jhk1m/charcoal-smoker/assets/COMPONENT_TO_INTEGRATE_REPLACE_V1.png

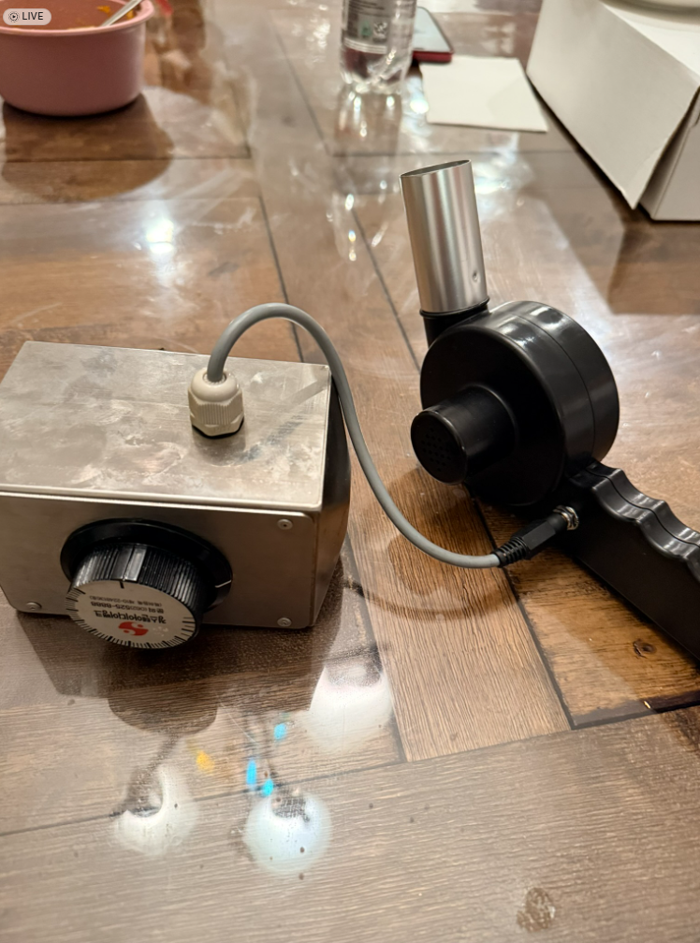
assets/COMPONENT_TO_INTEGRATE_REPLACE_V1.png
