jhk1m/charcoal-smoker/assets/FAN_CONTROLLER_ONOFF_DIAL_TEMP_SENSOR1_V1.png

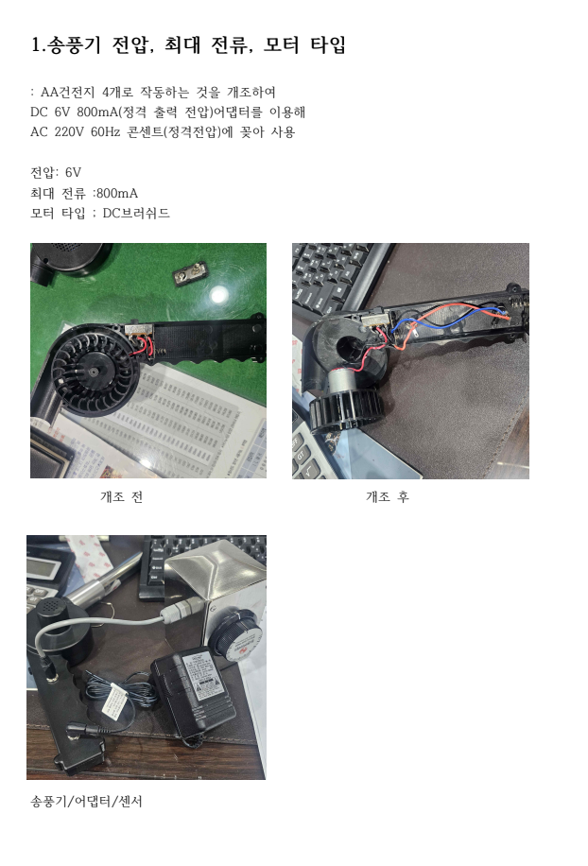
assets/FAN_CONTROLLER_ONOFF_DIAL_TEMP_SENSOR1_V1.png
