jhk1m/charcoal-smoker/output/09-open-items-and-gaps.md

# Open Items and Gap Register (audit 2026-09-22, updated 2026-10-05)

Purpose: one place that answers "are we done". Honest status, not a summary of what exists. Every line is either DONE, OPEN (with what unblocks it), or NOT BUILT (with the decision needed).
Audit method: read the firmware on JASON-PC, grepped for the features docs 06 and 07 claim, checked purchase status in doc 03 and 07, checked what the simulation exercised (doc 08).

## 0. Short answer
2026-10-22: short cooks (20 to 60 min, pit up to 200 C) are in scope, sear is out, manual mode set aside (N8, N9; doc 06 section 6a). Firmware for them built, flashed and bench-proven the same day; BLOWER_STALL proven three ways on the Delta (N7 closed). New hardware owed: dial to 270 C with the trip proven (M4), drum wall temperature at the port (M10), G4 thermal fuse (doc 07 A14).
Updated 2026-09-25. The control LOGIC is implemented, unit-tested, simulated, and now validated on the real ESP32-S3 against a simulated probe (doc 05). Nothing is wired: no breadboard, no replacement blower, no sensor connected, no thermostat check. No threshold in the firmware is a measured value. Several features the docs promise are not built, including all 4-wire fan support. It is not "done".

Docs currency as of 2026-09-25: 00 handoff created; 01 (air path, duct), 02 (rewritten for the Delta and the hardware bring-up), 03 (arrivals, breadboard correction, superseded items), 04 (4-wire wiring), 05 (bring-up record), 06, 07, 08, 09 all current.

Evening 2026-09-25 additions: blower adapter designed, verified and submitted for print (doc 07 A3, output\3d-print\); parts ordering consolidated at Mouser, breadboards and 2N7000s ordered; local firmware build confirmed (doc 05); native tests found NOT runnable on JASON-PC (new gap B4); doc 07 order status contradictory (new gap B5); git repo re-rooted from firmware\ to the project directory so the docs are versioned too.

2026-09-26: B5 closed (all ordered), breadboards on hand. Repo pushed to github.com/jhk1m/charcoal-smoker. The WROVER bench session was reconstructed from the Cowork transcript into doc 05: both MAX31855 boards read about 23 C low with the input shorted, wiring and supply verified, both returned (M8). No pit sensor on hand until the MAX31856 lands; section 2a is its incoming inspection, now console command `i`. New env s3-n8r8-uart (MAX31856 on the CH343 console) is the bench default. Bench probe polarity: crimped bare lead is T- (doc 04). OSOYOO S3 IO breakout proposed by Cowork, order status unrecorded (doc 07 A14).

2026-10-02: three Mouser lines received, 1N5822, ADS1115 breakout (Soldered 333095), CPT-2416-85T buzzer (doc 07). Untested. Also in: the Delta blower (label "BFB0712HH-A DC12V 0.42A"; -AWPH and four leads confirmed by Jason; outlet measured, see M1) and the K-type EGT pit probe (1/8 NPT compression fitting, 3.2 in; junction type untested: sheath-to-lead continuity means grounded, which the metal drum rules out, doc 03). 2N7000 x20 (onsemi) also in. Jumper kit not reported as received. Bench step 2 (M5 running current) can begin with the fan on straight 12 V; the fan drive hardware is now all on hand, so PWM drive and the start-duty measurement wait only on the section 6a firmware (inverted duty, 25 kHz). The buzzer needs a 2N7000 to drive it (doc 07 B5) and has no pin in pins.h (N3).

2026-10-04: section 6a (4-wire fan support) BUILT in the CLI session: inverted PWM, SUPPLY_EN, PCNT tach, BLOWER_STALL, BLOWER_RUNAWAY, fan_rpm in the dump and the CSV. All five ESP32 envs build; 39/39 unit tests pass under WSL2 (B4 partly closed). It has not met a fan: section 6a lists what the bench still owes. Two findings from the work: M9 (low-side supply cut and the signal leads) and the start kick lasting about 1 s instead of 300 ms (doc 05). On a bare board a cook now stops on BLOWER_STALL unless `T 0` is typed first.

2026-10-04 and 10-05, S3 bench (doc 05 "S3 bench session"): the S3-N8R8 is the bench and first-smoker board (Jason), the WROVER is retired from the bench. The 4-wire build boots on the bare S3. MAX31856 board 1 passed `i` on the S3 pins. The EGT probe is ungrounded and correctly poled but inaccurate (3.5 C high in ice, 4 to 5 C low at 88.9 C); kept for the first tests with `o 6.5`, replacement to follow. The Delta runs on straight 12 V (current not reported). M9 measured: 10.85 V on both signal leads with the supply cut, so the tach lead needs a fix before it meets a GPIO; the choice is open. Found, not fixed: `i` prints `present` and `shorted-input PASS` on an unpowered sensor.

2026-10-09, CLI session: M9 fix DECIDED by Jason, blocking diode in the YELLOW lead (M9, doc 04). Both findings from 2026-10-04 FIXED in firmware and built on all five envs, not flashed (doc 05 "Two driver fixes"): the start kick ends at 300 ms, and an unpowered MAX31856 reads NOT DETECTED.
2026-10-10, CLI session, second bench session (doc 05): M5 current 0.27 A at 100 percent; 10 percent start repeated 3 of 3, `n 15` saved; the unpowered-sensor fix was incomplete (chip unpowered AFTER boot still read present and 0.00 C as valid), fixed again in `selfTest()` and `read()`, flashed, proven: `i` NOT DETECTED and a cook faults SENSOR_OPEN at once.

2026-10-10, S3 fan bench (doc 05 "S3 fan bench"): M9 diode fix built and measured (3.2 V at the tach row with the supply cut), the M9 meter loads cut out of YELLOW and BLUE, all four fan leads on the S3 per doc 04 map C, today's build flashed. Fan runs under firmware: 4615 RPM at 100 percent, ppr 2 confirmed, duty sweep 5 to 100 percent (starts at 10, stops at 5), BLOWER_RUNAWAY and BLOWER_STALL both fired with the fan running and cut the supply. Section 6a bench list closed except M5 current. The start kick is written at the max duty cap, not 100 percent.

## 1. Blocking the bench bring-up (fix first)

| # | Gap | Evidence | Fix | Effort |
|---|---|---|---|---|
| B1 | DONE 2026-09-24: serial bench console added (src/ui/console.*). `?` lists the commands; `t <C> [C/s]` runs the state machine against a simulated probe with nothing wired. Originally: no runtime way to change PWM frequency, min-start duty, PID gains, max duty, or lid detect. `Blower::setFrequency`, `StateMachine::setGains` and `setLidDetectEnabled` exist but are never called; `main.cpp` has no Serial input; BLE exposes none of them. Every bench value change means editing config.h and reflashing, and bring-up steps 2, 3 and 6 are iterative by nature. | grep: no callers of those methods; no `Serial.read` in main.cpp; 10 BLE characteristics, none for config | Serial command console on the existing 115200 link (set freq, duty, gains, min-start, max, setpoint, lid-detect on/off, dump settings), and/or the same as BLE config characteristics | half a day |
| B2 | DONE 2026-09-24: probe_offset_c in NVS, applied in PitSensor::read, set with the console `o <C>`. Originally: no probe offset or calibration storage. Doc 06 E14 calls for a per-probe offset (Traeger allows -15 to +15 F, HeaterMeter has `Offset`); nothing in the firmware has one, so the ice/boiling check in bring-up step 3 has nowhere to land. | grep: no "offset" in src/ | Add `probe_offset_c` to NVS settings, apply in `PitSensor::read`, expose in the console from B1 | 1 hour |
| B3 | DONE 2026-09-25: git init run in firmware/, first commit 5393feb. Evening: the .git directory was moved up to the project root so output\ (docs, spec PDFs, 3d-print) and HANDOFF.md are versioned with the firmware; .gitignore paths adjusted (firmware/sim/sim, firmware/sim/out/*.csv). Git is run locally (PowerShell or Claude Code CLI on JASON-PC), never through the Claude device bridge, because the bridge cannot delete files and a stale .git\index.lock then has to be cleared by hand. | no .git in firmware/ at audit time | commit per bench session | 5 minutes |
| B4 | PARTLY CLOSED 2026-10-04: WSL2 Ubuntu on JASON-PC has g++ 13.3.0, and the tests run there by compiling test_control.cpp, pid.cpp, state_machine.cpp and Unity's unity.c directly (39/39, doc 05); the simulation compiles the same way. `pio test -e native` on Windows is still blocked as below. OPEN 2026-09-25: `pio test -e native` cannot run on JASON-PC, "'gcc' is not recognized". No host g++ installed (msys64 present, no compiler). The 29/29 pass is from the container only. Same blocker for the simulation. | pio test output, doc 05 | install MinGW-w64 gcc (msys64 pacman mingw-w64-ucrt-x86_64-gcc) and add its bin to PATH, or run under WSL2 | 15 minutes |
| B5 | CLOSED 2026-09-25: Jason confirmed everything in doc 07 is ordered (blower, 1N5822, jumper kit, ADS1115, buzzer, breadboards, 2N7000s, local hose, clamps, flap sheet). The contradictory line in doc 07 was removed. | Jason, 2026-09-25 evening | none; wait for delivery | - |
| B6 | CLOSED 2026-10-22: every BLE write characteristic (0003, 0007, 0008, 000c) and the encrypted read (0009) lacked the plain WRITE / READ flag, so NimBLE refused every phone-side write since the first build (Write Not Permitted). Found by the first PC-side write test, fixed and proven the same day (doc 05 "BLE debug channels"). Added: console over BLE on 000d and CSV telemetry on 000e; `firmware/tools/pair.py` and `ble.py` are the PC client | bleak from JASON-PC: `d`, `a 1`, 000c write and read-back, 000e stream all PASS on a bonded link | nothing; phone client untested, same pairing with the passkey typed | done |

## 2. Blocked on physical measurements (nothing has been measured yet)

| # | Measurement | Unblocks |
|---|---|---|
| M1 | DONE 2026-09-24: duct OD 23.81 mm, wall 0.85 mm, bore 22.1 mm, run 20 in with two bends; the existing blower couples with a 1 in ID sleeve, about 1 in of engagement. 2026-09-25: Delta outlet 24.1 x 17.5 mm taken from the spec drawing; adapter designed and print submitted (doc 07 A3). Still owed: caliper check of the outlet on arrival. 2026-10-02: MEASURED on the real fan, outlet 39.90 x 25.00 mm outside, bore 35.90 x 17.50 mm, walls 2.00/2.00 and 6.00/1.50, collar 3.5 mm proud. The 24.1 x 17.5 figure was wrong; adapter v1 superseded by v6 direct (output\3d-print\README-blower-adapter-v6.md). Open: v6 STL not in the repo, and v6 has no place for the backdraft flap | Blower DECIDED on static pressure (doc 06 R8 and 3.3): Delta BFB0712HH-AWPH; 75 mm Same Sky and FireBoard ruled out |
| M2 | Exhaust stack: is there a cap, damper, or nothing | Every vendor's setup rule is "exhaust nearly closed"; without a damper the pit is at the mercy of weather |
| M3 | Fan-off draft test (fire lit, blower unplugged, door shut: does the pit climb past 120 C) | Whether the flap is mandatory. Doc 08 shows the controller loses authority entirely without it. 2026-10-02: Jason deferred the flap for the first tests (duct routed away from the barrel; adapter v6 has no flap), so this test is what decides whether it comes back |
| M4 | Thermostat: which terminal pair is closed cold, dial setting that trips, and that it re-closes | The hardware over-temp cutoff is unverified. Must trip above PIT_SOFT_LIMIT_C 200 C and above SETPOINT_MAX_C 180 C. 2026-10-03: thermostat KEPT (Jason), box and dial removed, switch moves into the new enclosure. Check still owed |
| M5 | Delta running current at 12 V and its real min-start and min-run duties (datasheet: 0.34 A rated, 0.42 A max, start at or below 30 percent). 2026-10-05: the fan ran on straight 12 V; the running current was NOT reported. 2026-10-10 duties MEASURED under firmware (doc 05 "S3 fan bench"): starts from rest at 10 percent with the 300 ms kick, runs at 10 percent (480 RPM), stops at 5 percent; one trial per point. MEASURED 2026-10-10 (Jason, meter in series on RED, temporary): 0.27 A at 100 percent (4585 RPM, free air), then "dropped to 0.01A" (30 percent hold or after stop, not pinned down). 10 percent start repeated: 4 of 4; 5 percent from rest dies within 5 s. `n 15` saved. BLOWER_MIN_RUN_DUTY_PCT data: 10. BUILT and BENCH-CHECKED 2026-10-22 as `cfg::BLOWER_MIN_RUN_DUTY_PCT = 10` with long-PWM hysteresis (doc 05 "S3 bench session 2026-10-22"). Same session, NEW fan property: after a stop through the PWM lead the Delta restarts 0 to more than 4 s late; after a supply cut it starts on the first tick (10 of 10). Firmware now cuts the supply for long-PWM off-phases | Power budget, the fuse value, BLOWER_MIN_START_DUTY_PCT and the future BLOWER_MIN_RUN_DUTY_PCT |
| M6 | Probe port thread; probe length needed to sit at grate level about 8 cm inboard. 2026-10-03: the existing side port stays with the thermostat bulb (photo in assets\, brass compression fitting on a stainless block), so the K-type probe needs its own threaded entry. DECIDED 2026-10-03 (Jason): tap a second 1/8-27 NPT hole in the same stainless block beside the brass fitting, so both sensors share the existing port at grate height and the drum wall is not drilled. Conditions to confirm first: block is solid (not folded sheet), about 20 mm between centres fits, both bores land inside the port opening, the port passes bulb plus 5 mm sheath. Tap drill 11/32 in (8.7 mm) per the standard chart, verify on the tap. Fallback if the block is hollow: 1/8 NPT bulkhead fitting through the drum wall at the same height, beside the port (not bought). Still owed: port hole diameter, block footprint, wall thickness | Probe placement error is the top cause of bad control (doc 06 E12) |
| M7 | Basket weight before and after two cooks | Burn rate, which calibrates the fuel gauge in P9 |
| M8 | CLOSED 2026-09-26: BOTH HUABAN MAX31855 boards failed the shorted-input test on the Freenove WROVER (T+ shorted to T-: pit_raw_c steady 2.0 to 2.5 C against cj_c 25.1 C, about 23 C low; expected within about 2 C; open-circuit fault correct when the short was removed; VCC 3.2 V). Numbers in doc 05. Both returned. No MAX31855 on hand | Bench step 3 (ice and boiling, probe offset) now waits only on the ice/boil run: MAX31856 board 1 passed section 2a 2026-10-01 on the WROVER (env freenove-wrover). S3 env for it: s3-n8r8-uart (MAX31856 on the CH343 UART console). The MAX31855 backend and the *-max31855 envs stay as untested fallbacks. Doc 03 corrected |
| M10 | Drum wall temperature at the probe port (and at the planned fuse spot) during a 200 C pit, first fire, with a surface probe or the EGT probe clamped to the wall | Whether the 257 C G4 thermal fuse (doc 07 A14) can sit there without nuisance trips, and the dial setting 270 C (M4) stays the first hard cutoff |
| M9 | MEASURED 2026-10-05 (Jason), concern CONFIRMED: 12 V on RED, IRLZ44N in the BLACK lead held off (gate 10 k to GND, no S3 connected), YELLOW and BLUE each read 10.85 V against the ground rail, and still 10.85 V with a 10 k resistor from the lead to ground (about 1.1 mA each, so a stiff source, not a ghost voltage). Meter showed -10.85 V, taken as reversed probes. Consequence: YELLOW must NOT go straight to FAN_TACH as drawn in doc 04; BLUE is acceptable as designed because it only meets the 2N7000 drain (60 V) and the firmware holds that FET off while the supply is cut. DECIDED 2026-10-09 (Jason): blocking diode in the YELLOW lead with the pull-up on the GPIO side, per the doc 04 blower section (1N5819, cathode toward the fan, 10 k pull-up plus 10 k series on the GPIO side). Not yet built; meter check of the GPIO-side node before GPIO5 is connected. The high-side cut and no-cut options are dropped. BENCH STATE 2026-10-09 (Jason): the 10 k loads used for this measurement were SOLDERED inline on the YELLOW and BLUE leads (BLUE's end plugged into the breadboard (-) rail), and the diode is now soldered on YELLOW. Both 10 k were meter-only and must come out before the leads meet the circuit: in series on YELLOW the tach low level lands near 1.8 V with a 10 k pull-up (not a valid S3 low); in series on BLUE it forms a divider with the fan's internal pull-up and the PWM low is unproven. The diode stays. Lesson recorded: any part added for one measurement is labelled temporary in the step. BUILT AND MEASURED 2026-10-10 (Jason): YELLOW's 10 k cut out; yellow lead with the 1N5822 (stripe toward the fan) into a breadboard row, 10 k from that row to the S3 3V3 pin (S3 on USB-C), jumper from that row to GPIO5. With 12 V on the fan and the supply cut, the row reads 3.3 V against S3 GND: diode orientation confirmed, 10.85 V blocked. GPIO5 connected after the reading. Next: BLUE's 10 k cut out, BLUE to the 2N7000 drain, GPIO4 and GPIO6 per doc 04 map C. Original entry follows. NEW 2026-10-04, raised while writing the 4-wire firmware, NOT verified (the fan's internal circuit is not in the datasheet): the supply cut is an IRLZ44N in the fan's BLACK (ground) lead. With it off, the fan's internal ground is no longer tied to controller GND and can float up toward +12 V, and the YELLOW (FG) and BLUE (PWM) leads are referenced to that floating ground. Measure both leads against controller GND with 12 V applied and SUPPLY_EN low, before either is connected to a GPIO. Firmware side: the PWM GPIO is held low whenever the supply is cut, so the 2N7000 is off and gives the fan no ground return through the PWM lead; the 2N7000 drain is rated 60 V | Whether FAN_TACH can go straight to a 3.3 V GPIO as drawn in doc 04. If the FG lead rises above 3.3 V: add a series resistor between the FG node and the GPIO, or move the cut to the high side (P-channel MOSFET in the RED lead). Jason's decision, nothing bought |

## 2a. MAX31856 incoming inspection (written in the Cowork session 2026-09-25, landed on disk 2026-09-26)
The generic MAX31856 2-pack (Amazon, received by 2026-10-01) is CRITICAL PATH: both MAX31855 boards were defective and returned (M8), so there is no interim pit sensor. Test each board in this order before wiring it to the bench:
1. Chip laser-marked MAX31856 with the Maxim or ADI logo; board layout matching the Adafruit 3263.
2. 3.3 V on 3Vo with 5 V in (the board regulator), before the S3 sees it.
3. Register readback, the decisive test: setThermocoupleType(J), getThermocoupleType() returns J, then set K. A MAX31855 has no writable registers, so a relabeled part cannot pass. Library calls VERIFIED in Adafruit_MAX31856.h lines 121 and 122 (v1.2.8, installed in .pio\libdeps).
4. Cold junction reads room temperature with nothing attached.
5. readFault() raises the open-circuit bit with the thermocouple disconnected; clears with T+ shorted to T-.
6. Shorted-input check: thermocouple reading equals the cold junction within about 2 C (the test that failed the MAX31855s).
7. Ice and boiling water, then console `o <C>` for the offset.
If a board fails: buy the Adafruit 3263, not another unbranded board. There is no MAX31855 fallback any more.
BUILT 2026-09-26: console command `i` runs steps 3 to 6 (PitSensor::selfTest, src/hal/pit_sensor.cpp; judgement in src/ui/console.cpp). Re-probes the chip so a board plugged in after boot is found. Both UART envs build; not yet run on hardware, no MAX31856 in hand.
RESULT 2026-10-01, board 1 of 2, WROVER (env freenove-wrover, COM3, wiring per doc 04 pin map A): steps 3 to 6 PASS (doc 05 "WROVER MAX31856 inspection"). Step 1: chip marked MAX31856 (Jason, 2026-10-01; logo not recorded). Step 2 not recorded. Step 7 (ice/boil, offset) and board 2 still owed.
RESULT 2026-10-04, board 1 again, on the S3 (env s3-n8r8-uart, COM6, doc 04 pin map C): steps 3 to 6 PASS. Step 7 done with the EGT probe: 3.5 C high in ice, 4 to 5 C low at 88.9 C against a reference thermometer, `o 6.5` set as an extrapolation to cook temperature (doc 05 "S3 bench session"). Board 2 still owed.
FOUND 2026-10-04, not fixed: with the sensor unpowered every register reads zero and `i` still prints `present` and `shorted-input PASS` (0.00 against 0.00). The readback line is the one to trust.

## 3. Parts still to buy (doc 07)

Superseded 2026-09-25 by doc 07 "Order of purchase": one Mouser cart is the rule. Ordered: BB830 breadboards x2, 2N7000 x20 (Mouser order 1); blower per doc 07 STATUS, but see B5. Local trip: 1 in ID heater hose, four worm clamps, 0.4 to 0.5 mm silicone sheet, gasket tape. ThermoWorks: probes x2 once the plug is measured (B3). Closed without purchase: A8 diode (1N5819 on hand is adequate), B4 resistors (10 k 1 percent on hand). Still blocked on measurements: A10 exhaust damper (M2), B3 jacks, C1 to C4 enclosure.
Received: ESP32-S3 boards and MAX31855 boards 2026-09-23. MAX31856 2-pack received by 2026-10-01; board 1 passed section 2a. The MAX31855s were returned 2026-09-26. Received 2026-10-02: 1N5822, ADS1115 breakout, CPT-2416-85T buzzer, Delta blower, 2N7000 x20, K-type EGT pit probe (doc 07 "RECEIVED", doc 03). The Delta ran on straight 12 V 2026-10-05 and the EGT probe was tested 2026-10-04 (doc 05); the rest untested.

## 4. Built but not validated on hardware
- Every threshold in config.h is a design value from doc 06, not a measured one: PID gains, lid rate 0.3 C/s, FUEL_LOW 5 C over 10 min, FIRE_OUT 40 C for 15 min, CREEP 14 C for 15 min, startup cap 50 percent, max duty 60 percent.
- The rising-lid check (drum lid open raises the pit) is a proposal of ours. No commercial controller documents it and it has not been seen on this drum.
- The simulation (doc 08) used an assumed plant. It found two real bugs, which is what it is for; it cannot confirm tuning.

## 5. Not built, spec'd only

| # | Feature | Where spec'd | Needed for |
|---|---|---|---|
| N1 | Cook Manager: meat state machine, stall detect, wrap prompt, ramp-down, hold, rest, food-safety watchdogs | doc 06 section 6 | Any meat-probe behaviour. Needs B1 probes + ADS1115 |
| N2 | Fuel gauge, FUEL_LOW lead time from basket load, REFUEL state, lump vs briquette selector | doc 06 P9, section 1b | Charcoal-specific handling, the thing that differentiates this build |
| N3 | Local alarm (buzzer) | doc 07 B5; buzzer on hand 2026-10-02 (CPT-2416-85T, 12 V, low-side 2N7000 drive); no pin assigned in pins.h | Unattended or overnight cooks. Today a FIRE_OUT at 2 am is silent unless the phone is in range and awake |
| N4 | Event log persistence in flash | doc 05 (RAM ring buffer, flash is Phase 2) | A power cut loses the cook trace, which is exactly what tuning needs |
| N5 | OTA update | doc 02 section 8 | Otherwise every firmware change is a USB cable at the smoker |
| N6 | Pairing button; the pairing window opens at boot. Passkey moved to the git-ignored `firmware/.env` 2026-10-23 (doc 05), the old constant is retired. 2026-10-22: JASON-PC bonded through that window (`tools/pair.py`); the bond persists across reflashes, so the window is needed again only for a new phone or after `r` / NVS erase | doc 05 OPEN items | Anyone in range during the first 60 s after power-up can bond |
| N7 | CLOSED 2026-10-22: proven on the Delta three ways (dead fan, lost tach at steady 10 percent, lost tach inside a long-PWM on-phase; doc 05 "Short cooks build" item 6). Blower stall detection | doc 06 E17 | Only exists if a 4-wire fan with tach is chosen. On a 2-wire fan a dead blower shows up as FIRE_OUT 15 min later |
| N8 | Short cooks (20 to 60 min, pork belly or chicken class). DECIDED 2026-10-22 (Jason): sear DROPPED, short cooks stay, PIT_OVER_LIMIT becomes dynamic, a hard cutoff is required. Spec and researched numbers in doc 06 section 6a (PROPOSED): SETPOINT_MAX 200, over-limit = setpoint + 40 capped at 240, dial thermostat fixed at 270 as the hard cutoff (M4 proves the trip), optional Thermodisc G4 one-shot fuse (max 257 C) on the drum wall, countdown timer with alarm. Numbers CONFIRMED and firmware BUILT 2026-10-22 (doc 05 "Short cooks build"): SETPOINT_MAX 200, limit = setpoint + 40 capped at 240, timer with TIMER_DONE. Still open: dial to 270 and M4 trip proof; a 175 to 200 C cook to confirm gains. G4 fuse DECIDED yes 2026-10-22 (doc 07 A14, wall temperature M10 first) | doc 06 section 6a | Half the mission. Today the firmware can only do low-and-slow |
| N9 | Manual mode: constant blower duty plus a countdown timer, no PID | set aside by Jason 2026-10-22; doc 06 section 6a | Nothing yet. Console `m` already gives constant duty by hand |

## 6. Edge cases in doc 06 with no implementation yet
- E9 ash choke / lit-mass creep detector (rising average duty over hours): CREEP covers the duty-0 case only.
- E13 stuck sensor: a thermocouple that returns a plausible constant value is not detected. The MAX31856 fault bits catch open, short and range, not a frozen reading. NEW: add a "no change greater than 0.5 C for 10 min while duty is above 20 percent" check. Not in the catalog before this audit.
- E20 water pan gain set: one gain set exists, not two.
- E28 fuel type selector: not implemented (part of N2).
- E23 phone away: see N3.

## 6a. New firmware work created by the blower decision (2026-09-24)
The Delta is a 4-wire brushless fan, so the drive model changes. BUILT 2026-10-04, build-verified and unit-tested, NOT run against a fan (detail and results in doc 05, "4-wire fan support").
- BUILT: PWM polarity inverts (open-drain driver). `cfg::BLOWER_4WIRE` selects it; `-DBLOWER_LEGACY_2WIRE` builds the old model.
- BUILT: PWM frequency held to 21 to 28 kHz, default 25 kHz (Intel 4-wire range), in the console `f` and at NVS load. The 25 kHz vs 200 Hz bench comparison in doc 02 no longer applies once the Delta is fitted.
- OPEN, bench: datasheet minimum start duty is at most 30 percent, so the long-PWM path stays in use. Measure the real start duty and the lower RUN duty (M5), now readable as fan_rpm in the CSV.
- BUILT: tach input on a PCNT pulse counter with a 10 us glitch filter, RPM in the `d` dump and the CSV. OPEN, bench: the datasheet FG waveform shows four equal intervals per revolution on a 4-pole motor, which reads as 2 pulses per revolution; NOT confirmed by measurement, so count it and set it with `p <n>` before trusting an RPM figure.
- BUILT: fault BLOWER_STALL: duty above 0 with no tach pulses for 3 s, RAISED to 5 s 2026-10-22 (the Delta restarts up to 3 s late after a PWM-lead stop, doc 05 "S3 bench session 2026-10-22"; the long-PWM off-phase now cuts the supply instead, and on-phases are at least 5 s so a dead fan still faults inside one). As built, the seconds are driven seconds: long-PWM off time neither counts nor clears. An open thermostat contact or a dead 12 V supply also shows up as this fault. PROVEN 2026-10-22 under the supply-cut model: dead fan (BLACK pulled), lost tach at steady 10 percent, and lost tach inside `m 5` long-PWM, fault at the end of the first pulse-less on-phase (doc 05 "Short cooks build" item 6).
- BUILT: fault BLOWER_RUNAWAY: measured RPM far above the commanded speed for 5 s, which is what a broken PWM lead looks like on this fan. Action: drop SUPPLY_EN (cuts the fan through the IRLZ44N) and fault. As built, "far above" is RPM greater than commanded percent of 4400 plus 25 percent of 4400 (1100 RPM); at the 60 percent duty cap that is 3740 RPM, under the 3960 RPM of a fan at the low end of the +/- 10 percent tolerance. OPEN, bench: the margin assumes speed roughly linear in duty; check it against measured RPM at 30 to 60 percent, a fan that runs well above linear would fault falsely.
- BUILT: the IRLZ44N moves from carrying PWM to a supply cut on its own GPIO. As built it is cut in IDLE as well as in FAULT, and on at every other time, including duty 0 (the fan is held stopped through the PWM lead, and the runaway check watches it).
- DONE earlier: pins.h has TACH and SUPPLY_EN for all three board maps (doc 04).
- CLOSED 2026-10-10 (doc 05 "S3 fan bench"): with the fan running at 30 percent, BLUE opened gave BLOWER_RUNAWAY 5 s after the RPM crossed the threshold, and YELLOW pulled gave BLOWER_STALL after 3 driven seconds; both cut the supply and the fan stopped. ppr 2 confirmed (4615 RPM at 100 percent). The 4-wire firmware is validated on the Delta. Still open from this list: M5 running current, and `n` (min start) to be lowered from 30 once the 10 percent start is repeated.
- Bench switch: `T 0` turns both tach faults off until the next boot, for a board with no fan attached.

## 7. Recommended order
1. DONE 2026-09-24/25: B1 bench console, B2 probe offset, B3 git init. Firmware validated on the S3 with the
   simulated probe: IGNITE, RAMP, HOLD, LID_OPEN, over-temp FAULT and fault latching all behaved as designed
   (doc 05, "First hardware bring-up"). Four console bugs found and fixed in the process.
1b. Breadboards ON HAND (2026-09-25 evening). Rails under load (bench step 2a) can start now. Blower work waits on the Delta and the 2N7000s, all ordered 2026-09-25 (doc 07); adapter print in progress, STL in output\3d-print\. Until they arrive the board can still be flashed and driven with the console's simulated probe. Meanwhile: resolve B5, fix B4 so the native tests run locally, and build the 4-wire fan support in section 6a so it is ready when the Delta lands.
2. DONE 2026-09-23/25: boards arrived, bench step 1 complete (flash and run, simulated probe). Bench step 2 (rails and blower under load, M5, real min-start duty) is blocked on the breadboard and the Delta. M5 is now the Delta's running current at 12 V, not the old 6 V blower's.
3. Any time: measure M1, M2, M6; run M3 with the next fire; order the ready-now parts in doc 07 section A/B.
4. MAX31856 board 1 inspected 2026-10-01. Next: ice/boiling calibration into B2, then the step-response cook, then gains.
4b. Field-test path agreed 2026-10-03, bench first: (1) EGT probe sheath-to-lead continuity, (2) EGT probe on the MAX31856, ice and boil, `o <C>`, (3) 12 V in and the buck at 5.0 V measured before the board connects, (4) Delta on straight 12 V, running current (M5), (5) thermostat closed pair and trip (M4), (6) dry-fit adapter v6. Smoker: (7) tap the second 1/8 NPT hole in the port block (M6), (8) fan-off draft test on the first fire (M3). Firmware: section 6a 4-wire support, BUILT 2026-10-04, build-verified and unit-tested only until it meets the fan; before the fan's signal leads touch a GPIO, do M9, between steps (4) and (6). DECIDED 2026-10-04 (Jason): the S3-N8R8 goes on the breadboard and in the smoker first (doc 04 map C, env s3-n8r8-uart). STATUS 2026-10-05: (1) DONE, ungrounded. (2) DONE on the S3, probe inaccurate, kept with `o 6.5` (doc 05). (3) 12 V input chain built; the buck is not reported as set. (4) the fan runs, current not reported. M9 DONE: 10.85 V on both signal leads, tach fix open. (5) and (6) not done. STATUS 2026-10-10: M9 fix built (1N5822 in YELLOW), all four fan leads on the S3, the 4-wire firmware validated on the Delta (ppr 2, duty sweep, runaway and stall faults; doc 05 "S3 fan bench"). Still open: (3) buck setting, (4) current, (5) thermostat, (6) adapter dry-fit.
5. Before the first real cook: flap, gasket, exhaust damper, thermostat verification M4, and N3 buzzer if the cook will be unattended.
6. Phase 2: N1 and N2 once the probes are in hand. ADS1115 received 2026-10-02; the ThermoWorks probes (doc 07 B1) are not.
