jhk1m/charcoal-smoker/assets/AIR_FLOW_V1.png

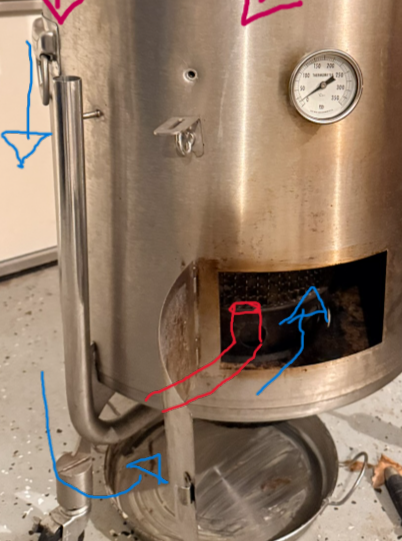
assets/AIR_FLOW_V1.png
