jhk1m/charcoal-smoker/assets/CHARCOAL_SMOKER_V1.png

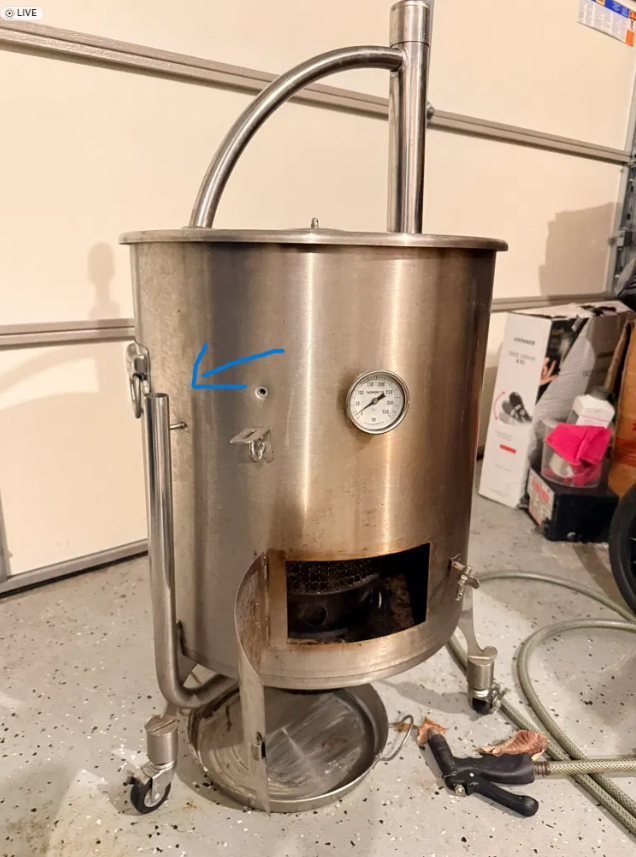
assets/CHARCOAL_SMOKER_V1.png
