jhk1m/charcoal-smoker/assets/DIAL_TEMP_SENSOR_V1.png

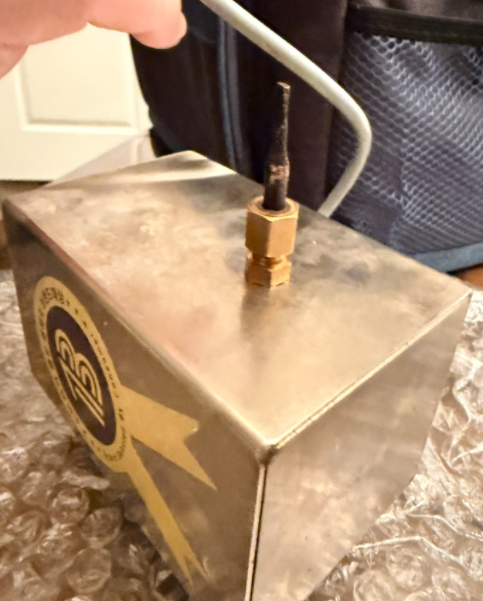
assets/DIAL_TEMP_SENSOR_V1.png
