jhk1m/charcoal-smoker/Claude outputs/blower_zoom.png

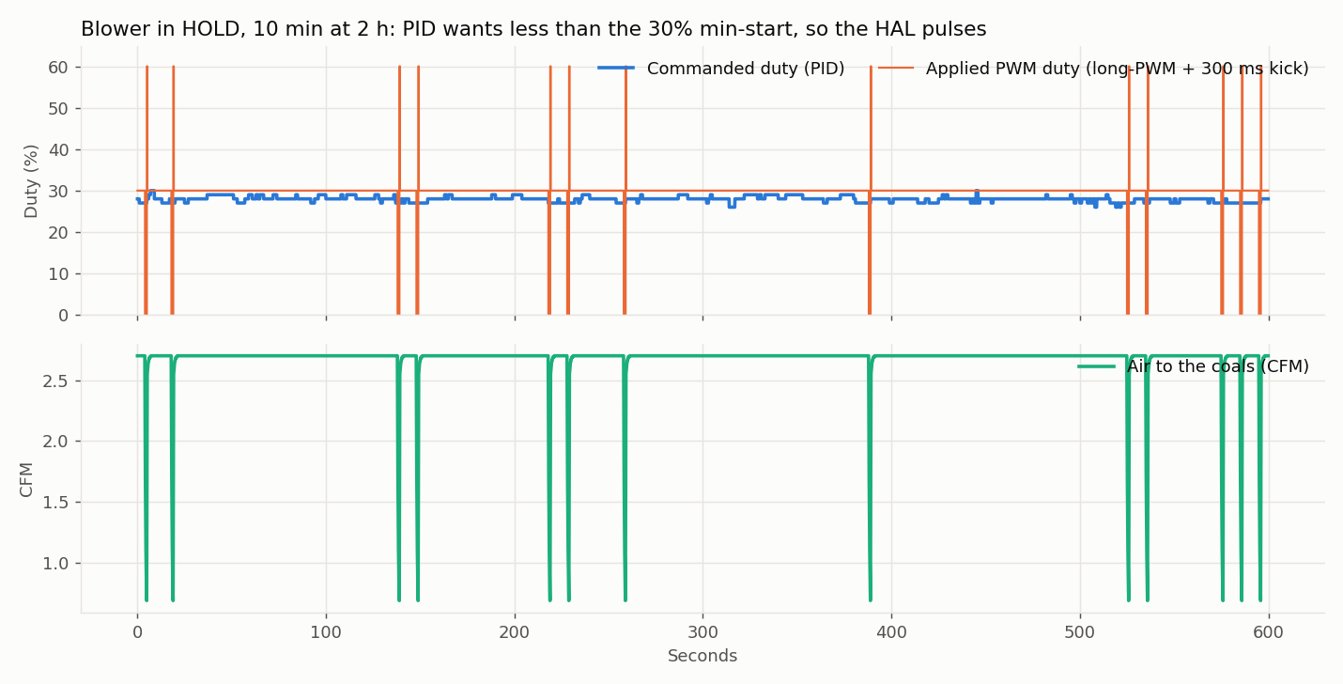
Claude outputs/blower_zoom.png
