jhk1m/charcoal-smoker/Claude outputs/flap_compare.png

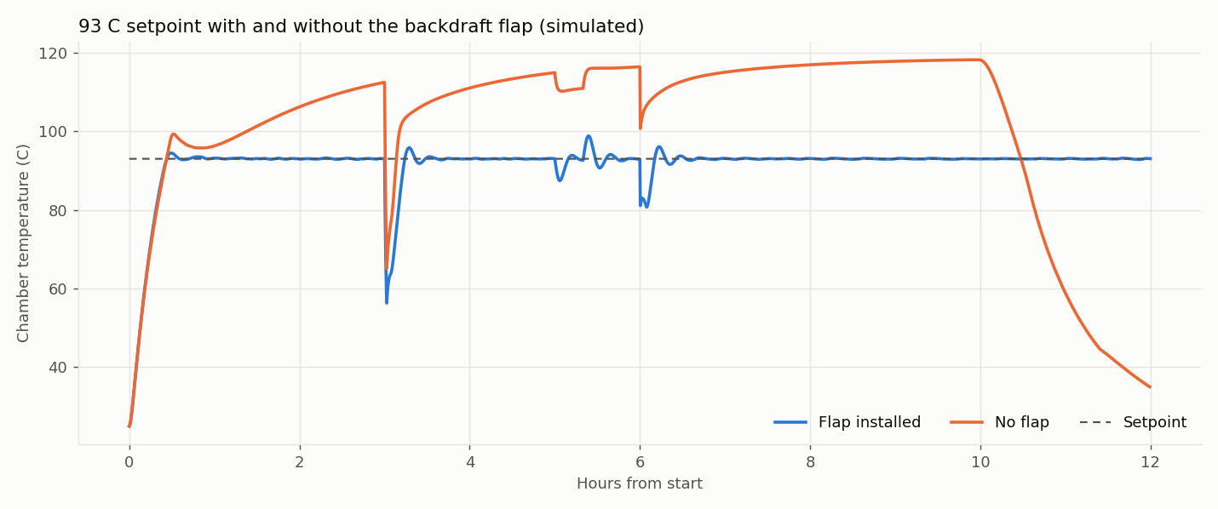
Claude outputs/flap_compare.png
