jhk1m/charcoal-smoker/Claude outputs/nominal_overview.png

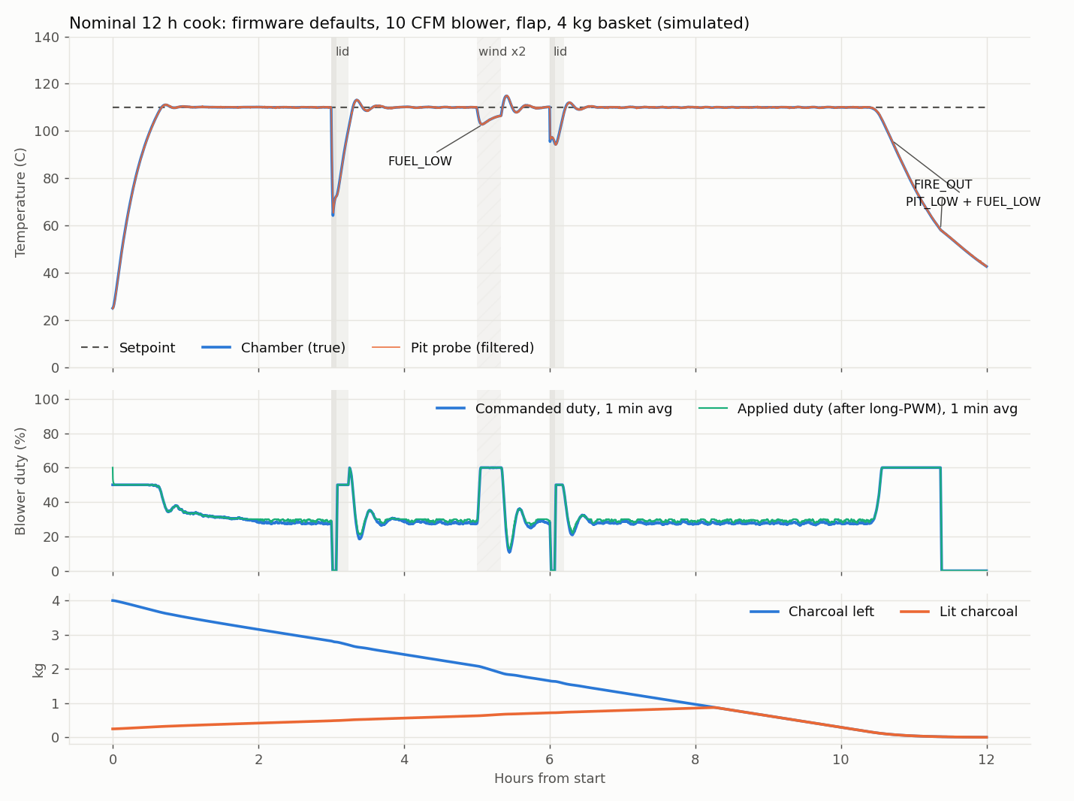
Claude outputs/nominal_overview.png
