jhk1m/charcoal-smoker/Claude outputs/startup_compare.png

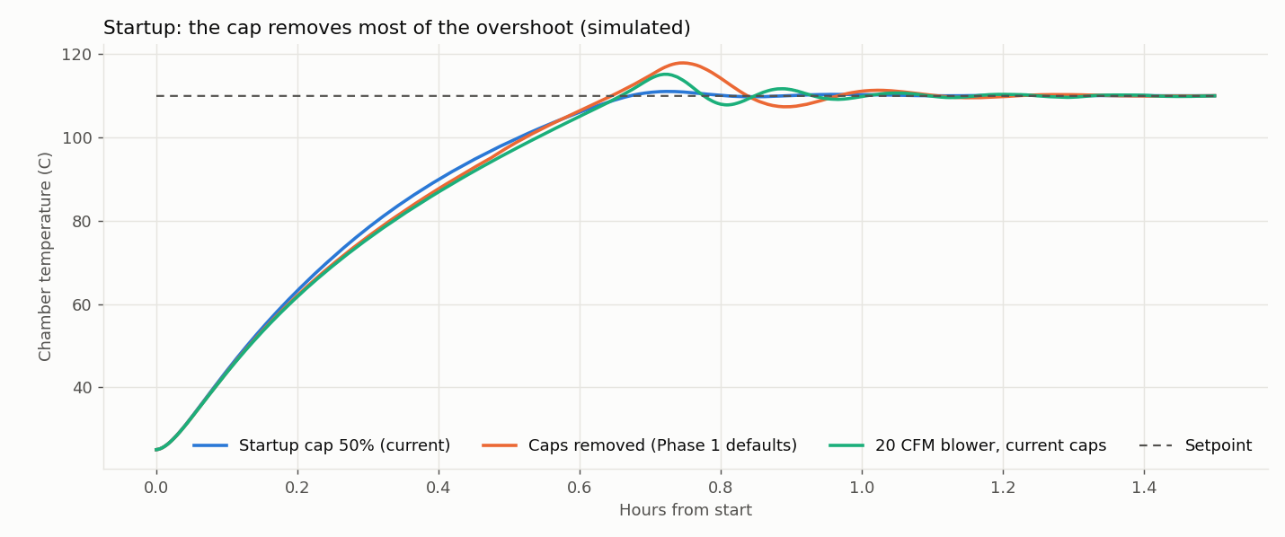
Claude outputs/startup_compare.png
