jhk1m/charcoal-smoker/firmware/sim/out/no_flap_93c_overview.png

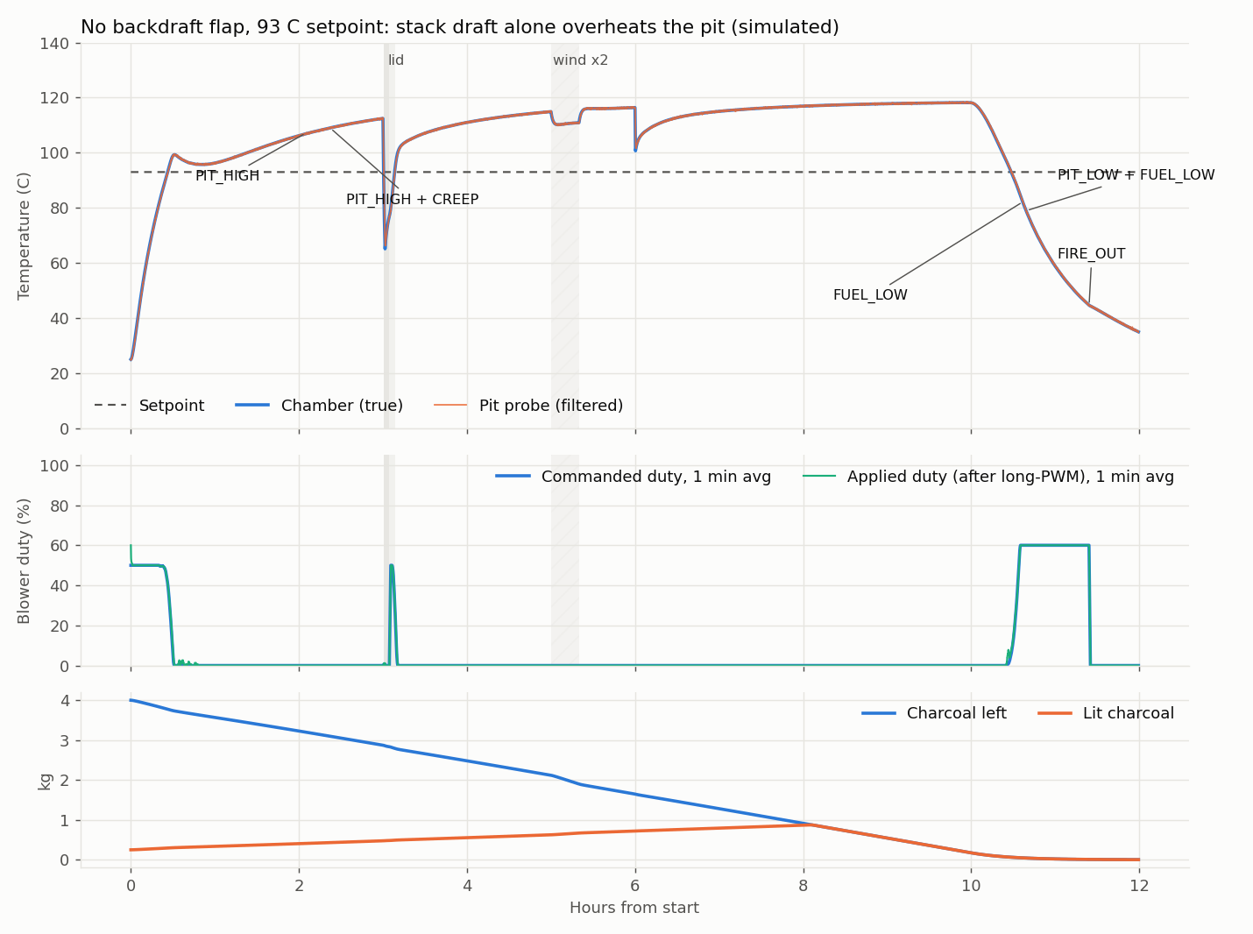
firmware/sim/out/no_flap_93c_overview.png
