jhk1m/charcoal-smoker/output/3d-print/blower-adapter-v6-direct.stl

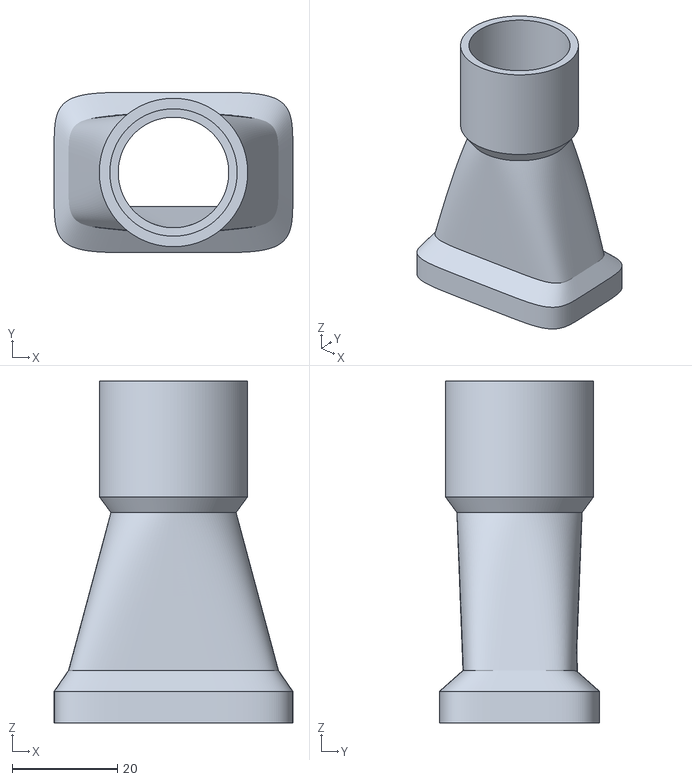
[picture p12: CAD file, 2026-10-05]
output/3d-print/blower-adapter-v6-direct.stl
45.4 x 30.5 x 65.0
