jhk1m/charcoal-smoker/output/3d-print/blower-adapter-delta-BFB0712HH-to-1in-duct-v1.stl

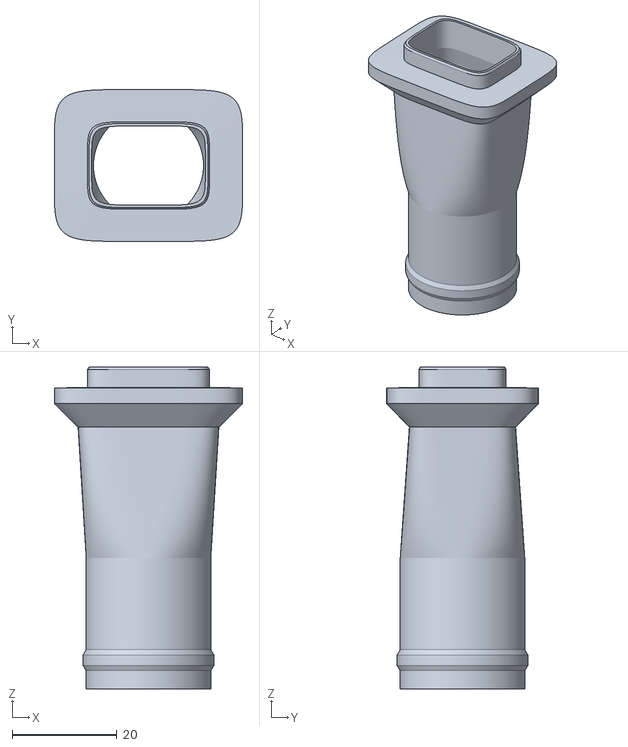
[picture p13: CAD file, 2026-09-25]
output/3d-print/blower-adapter-delta-BFB0712HH-to-1in-duct-v1.stl
36.0 x 29.0 x 61.5
