jhk1m/charcoal-smoker/output/3d-print/adapter-preview.png

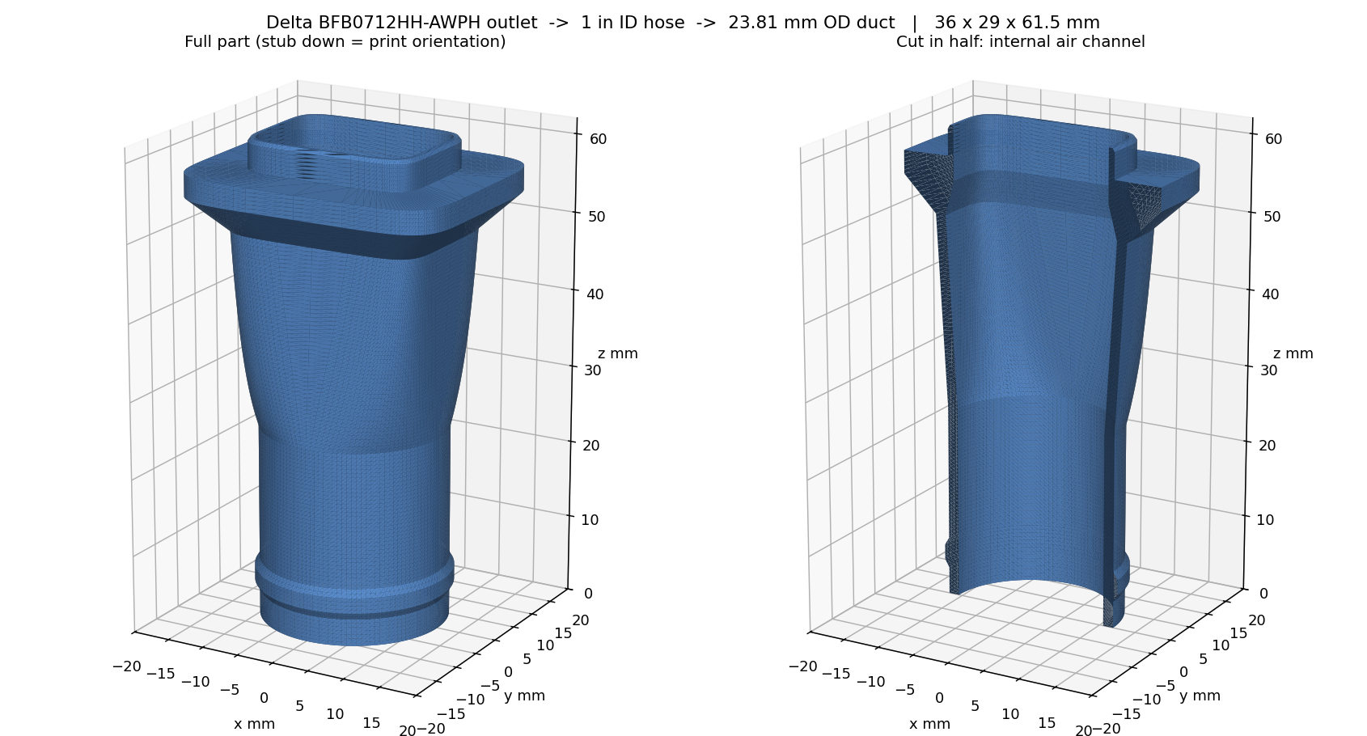
output/3d-print/adapter-preview.png
