jhk1m/charcoal-smoker/(commit log)

2026-09-25 Re-root repo to project directory; docs and results as of 2026-09-25
    Move .git from firmware/ to the project root so HANDOFF.md, output/ docs,
    spec PDFs and the 3D-print adapter are versioned with the firmware.
    .gitignore paths adjusted for the new root.
    Docs updated:
    - HANDOFF / 00: results table (S3 build SUCCESS, native tests blocked on
    JASON-PC by missing host gcc, STL verify), blower ordered, adapter
    designed and submitted for print, purchasing status, repo location.
    - 02, 03, 04: Delta outlet dims from spec drawing, adapter design,
    breadboard ordered, SS34 superseded by A8 closure.
    - 05: local build numbers, native-test blocker, test count 29.
    - 07: reconcile note on contradicto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
    [blower-adapter-delta-BFB0712HH-to-1in-duct-v1.stl]
2026-09-26 Breadboard correction: existing board too short for the S3 by two pins; BB830 x2 ordered
2026-09-26 Purchasing state confirmed: all parts ordered, breadboards on hand, adapter print in progress
2026-09-26 Both MAX31855 boards defective and returned; add s3-n8r8-uart env (MAX31856 on CH343 console) as bench default
2026-09-26 Doc 07: note proposed OSOYOO ESP32-S3 IO breakout board, order status unrecorded
2026-09-26 Record WROVER bench session: MAX31855 shorted-input numbers, supply and wiring checks, both boards returned
2026-09-26 Bench probe polarity: crimped bare lead is T- (magnet test); legacy blower stage not built
2026-09-26 Console: 'i' sensor identity check for MAX31856 incoming inspection
    PitSensor::selfTest() re-probes the chip, and on the MAX31856 writes
    thermocouple type J, reads it back and restores K (a relabeled MAX31855
    has no writable registers). Returns one raw tc/cj sample and fault bits.
    Console 'i' prints the result and judges it: open input must raise the
    open-circuit bit; shorted input must read the cold junction within 2 C.
    MAX31855 backend runs the sample-only part.
    Builds: s3-n8r8-uart 650662 B flash, s3-n8r8-uart-max31855 648630 B.
    Not run on hardware yet; no MAX31856 in hand.
    [console.cpp, pit_sensor.cpp, pit_sensor.h]
2026-09-26 Docs current to 2026-09-26: HANDOFF state, results table, bench env commands, MAX31856 critical path; doc 02, 05, 09 refreshed
2026-10-01 MAX31856 board 1 passes incoming inspection on the WROVER; docs current to 2026-10-01
    Console i: register readback PASS, open input 0x41, shorted input 0.11 C off the cold junction, probe polarity confirmed by pinch test. Chip marked MAX31856. WROVER recorded as the bench board with the echo monitor flags. Also commits the 2026-09-30 WROVER boot log in doc 05. Still owed: ice/boil offset, board 2.
2026-10-03 Parts received 2026-10-02; adapter v6, thermostat kept, probe entry decided; docs current to 2026-10-03
    Received: Delta BFB0712HH-AWPH (4 leads confirmed), 2N7000 x20, 1N5822 x2, ADS1115 breakout,
    CPT-2416-85T buzzer, K-type EGT pit probe. All untested. Jumper kit not reported.
    Fan outlet measured 39.90 x 25.00 outside, 35.90 x 17.50 bore, 2.25 mm off centre; v1 adapter
    superseded by v6 direct (spec recorded, STL not yet in repo). Flap deferred for first tests.
    Thermostat kept in series with the fan; box and dial go. Thermocouple enters through a second
    1/8 NPT hole tapped in the existing port block. Field-test sequence in doc 09 section 7 item 4b.
2026-10-05 4-wire fan support; S3 bench: MAX31856 and EGT probe tested, fan on 12 V, M9 measured; adapter v6 files; docs current to 2026-10-05
    [blower-adapter-v6-direct.stl]
2026-10-10 S3 fan bench: 4-wire firmware validated on the Delta; M9 diode fix built; kick and unpowered-sensor fixes; docs current to 2026-10-10
    Firmware: the control task sleeps to its 1 Hz tick in BLOWER_SERVICE_MS
    slices and services the blower in each, so the start kick ends at
    BLOWER_KICK_MS instead of the next tick. The MAX31856 backend requires the
    type K just written to read back before reporting the sensor present, so an
    unpowered board reads NOT DETECTED instead of a false shorted-input PASS.
    All five ESP32 envs build clean; flashed to the S3 on COM6.
    Bench: M9 fix decided (blocking diode in the tach lead, pull-up on the GPIO
    side) and built with a 1N5822; 3.2 V at the tach row with the supp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
    [config.h, main.cpp, pit_sensor.cpp]
2026-10-10 S3 bench second session: M5 0.27 A, n 15 saved; MAX31856 unpowered-after-boot fix in selfTest and read, flashed and proven; docs current to 2026-10-10
    [pit_sensor.cpp]
2026-10-22 S3 bench 2026-10-22: BLOWER_MIN_RUN_DUTY_PCT with long-PWM hysteresis; fix false BLOWER_STALL at setpoint; assets added
    The Delta restarts 0 to more than 4 s late after a stop through its PWM lead, but at once after a supply cut (10 of 10). At setpoint the PID asks 1 percent, so long-PWM gave one kick tick per 10 s and the stall counter faulted after three failed restarts.
    - config.h: BLOWER_MIN_RUN_DUTY_PCT 10, BLOWER_LONG_PWM_MIN_ON_S 5, FAN_STALL_S 3 to 5
    - LongPwm: min-run hysteresis, minimum on-phase with the period stretched; two new unit tests (41/41 under WSL2)
    - Blower: applied duty 0 cuts the fan supply so every long-PWM on-phase is a cold start
    - sim: plant fan moved to the measu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
    [blower.cpp, blower.h, config.h, long_pwm.h, main.cpp, plant.h, sim_main.cpp, test_control.cpp]
2026-10-23 Short cooks: dynamic PIT_OVER_LIMIT, SETPOINT_MAX 200, cook timer; BLOWER_STALL re-proven under supply cut; mission and hard-cutoff decisions
    Firmware:
    - SETPOINT_MAX_C 180 -> 200. PIT_OVER_LIMIT is now min(setpoint + PIT_OVER_MARGIN_C 40, PIT_SOFT_LIMIT_C 240) instead of a fixed 200 C.
    - Cook timer in StateMachine (setTimer, counts down in tick, TIMER_DONE warning bit 5 latched until re-set or stop). Console `a <min>`, BLE characteristic 000c (uint16 minutes, write enc). `d` prints limit and timer.
    - Tests: 42/42 (over-limit margin and cap, timer). Sim nominal unchanged. All five envs build clean.
    Bench (S3, COM6): limit 150 at setpoint 110 and 240 at 200; t 149 holds, t 150 faults; timer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
    [config.h, console.cpp, main.cpp, sim_main.cpp, state_machine.cpp, state_machine.h]
2026-10-23 HANDOFF: board 2 inspection skipped, spare only
2026-10-23 BLE debug channels, web UI, fix dead BLE writes and stale timer value
    - Console over BLE (000d): one parser for serial and BLE, replies notified back,
    queued onto the control task. CSV telemetry notify (000e) at 1 Hz.
    - Every write characteristic lacked the plain WRITE flag (WRITE_ENC/AUTHEN are
    modifiers), so no BLE write had ever worked; READ added to the event log too.
    - Timer (000c) now publishes minutes left with NOTIFY; the read value used to be
    whatever the phone last wrote.
    - tools/pair.py (WinRT ProvidePin bonding), tools/ble.py (bleak client),
    tools/ui.html Web Bluetooth UI; docs/index.html is the GitHub Pages copy for
    Bluefy on iPhone.
    - 42/42 tests under WSL2, five envs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
    [ble.py, config.h, console.cpp, console.h, main.cpp, pair.py]
2026-10-23 Move the BLE passkey out of source into a git-ignored firmware/.env
    - load_env.py (PlatformIO pre-script) turns firmware/.env lines into -D
    defines; config.h refuses Arduino builds without SMOKER_BLE_PASSKEY and
    uses 0 for host builds. .env.example is the template; .env is ignored.
    - tools/pair.py reads the passkey from .env.
    - The previously committed constant is retired. Docs 05, 09, README and
    HANDOFF updated.
2026-10-23 BLE: random passkey outside the pairing window; iPhone bonded via Bluefy
    A pairing attempt after the 60 s window used to create a bond, delete it
    and drop the link, leaving the phone with half a bond and iOS refusing every
    later connect ("peer removed pairing information"). The board now presents a
    random passkey outside the window so the attempt fails at PIN entry with
    nothing stored. Web UI proven on iPhone through GitHub Pages. Docs updated.
2026-10-23 UI: log every write and any thrown error; firmware: bond decision at passkey display, 120 s window, B command, write log
    [config.h, console.cpp, pair.py]
2026-10-23 UI: timer button sends the console command a <min>; native 000c write did not leave Bluefy
2026-10-23 Docs: pairing second pass, timer via console, bond command
2026-10-23 Timer seconds in the CSV telemetry; UI timer card reads it (Bluefy drops the 000c notify)
2026-10-25 Cook timer stops the cook at zero; clearing a fault drops a stale TIMER_DONE
    Timer end now goes to IDLE (fan off, cook_active cleared) with TIMER_DONE kept as
    the alert (Jason, 2026-10-25). clearFault() resets the timer like stop(), and
    startCook() drops the previous cook's alert. Docs: pre-cook scenario pass recorded
    in doc 05; decision in doc 02; doc 06 section 6a amended; README and HANDOFF.
    [console.cpp, main.cpp, state_machine.cpp, state_machine.h, test_control.cpp]
2026-10-28 MAX31856: re-initialise on an all-zero read before faulting SENSOR_OPEN
    The chip resets when the fan supply switches on (bench 2026-10-27) and comes back with conversions off, reading 0.00 C on both channels. read() now re-runs begin(), waits one conversion and re-reads; a chip that does not answer still faults SENSOR_OPEN. Bench: cook start held IGNITE 30 s with one re-init logged.
    [pit_sensor.cpp]
2026-10-28 UI redesign with hidden debug mode; operating manual (doc 10)
    Ring gauge, plain-language status, fault banner with actions, target stepper in F or C, state-aware start/stop, timer presets, restyled chart. The old raw view, console and CSV move to a debug panel (tap the title 5 times or #debug). Published at docs/app.html as well so Bluefy cannot serve a cached copy. Doc 10 covers states, faults and recovery, limits, console and BLE reference, Q&A.
2026-10-28 UI: disable double-tap zoom so quick taps reach the page
    On iOS the 5-tap debug gesture and fast +/- stepper taps were taken as double-tap zoom. touch-action: manipulation on the page; pinch zoom still works.
